smithwrinch/pcompproject/sonar.jpg

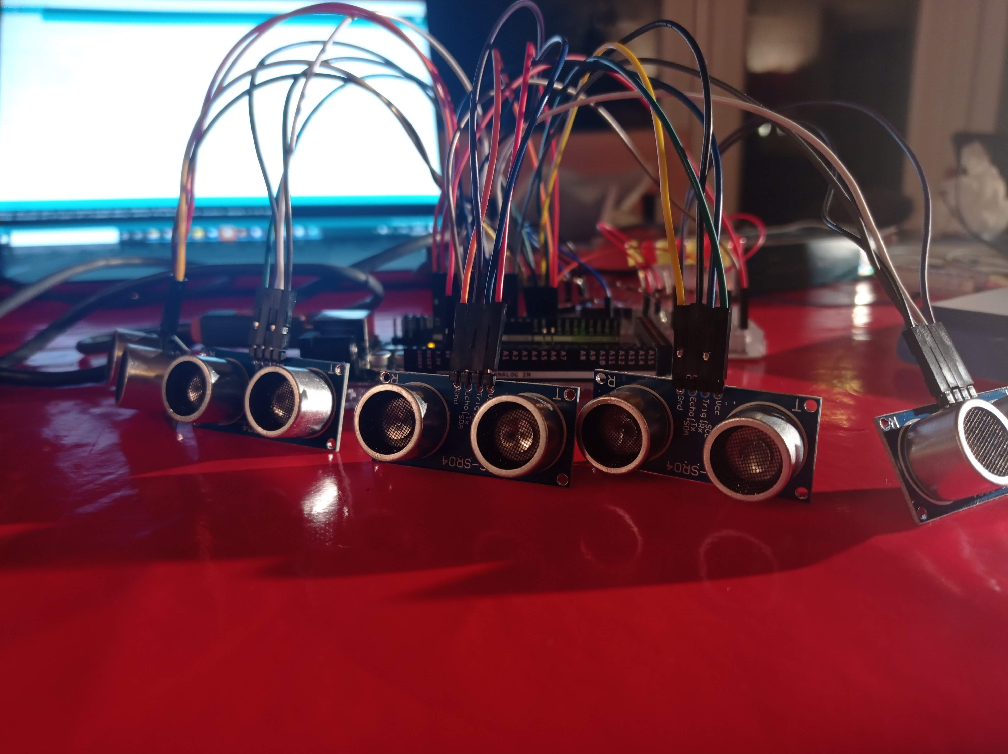
sonar.jpg
