smithwrinch/pcompproject/strip_wires.jpg

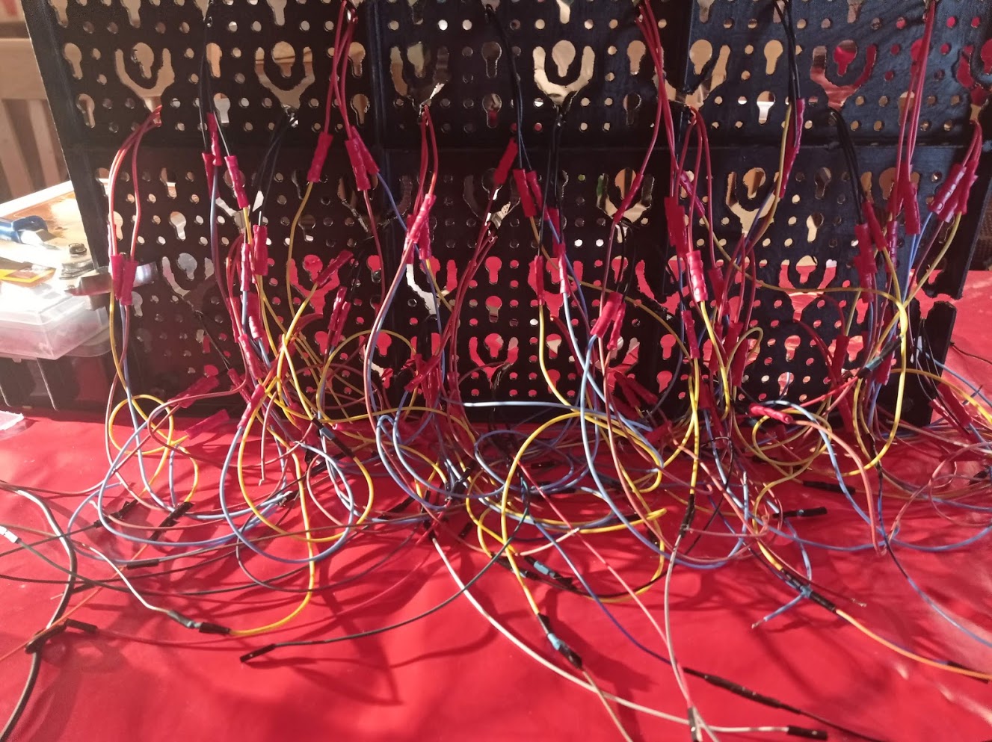
strip_wires.jpg
