smithwrinch/pcompproject/tiny_strip.jpg

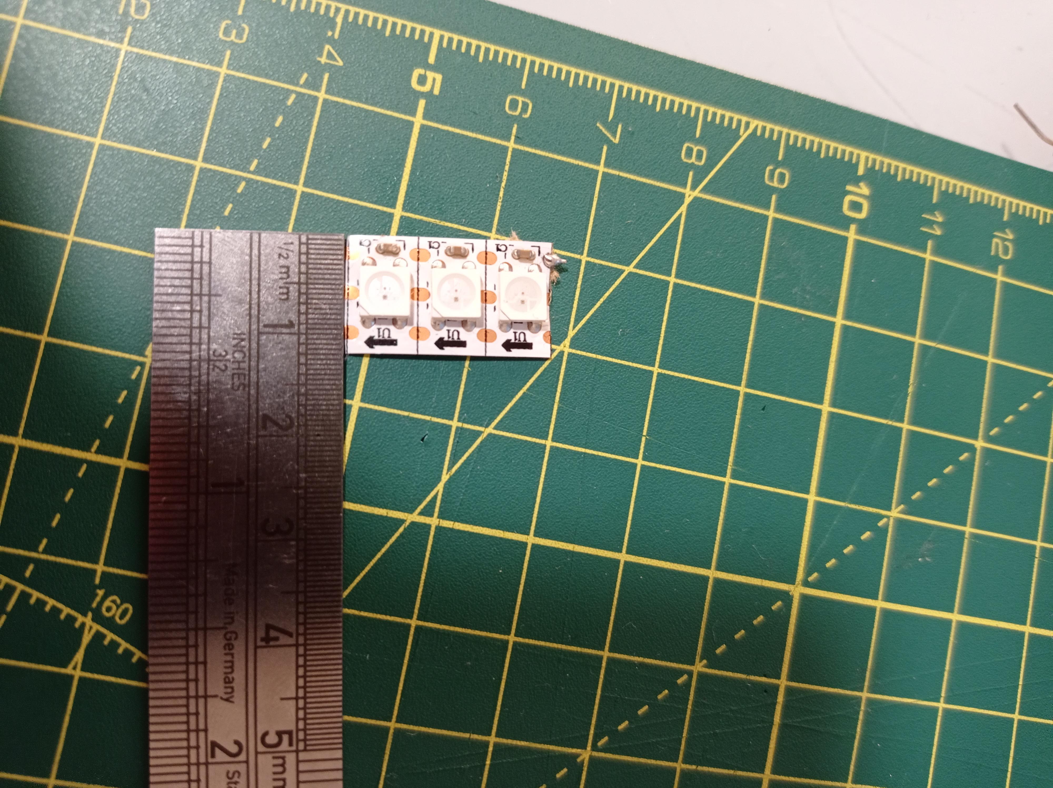
tiny_strip.jpg
