smithwrinch/pcompproject/test_strip.jpg

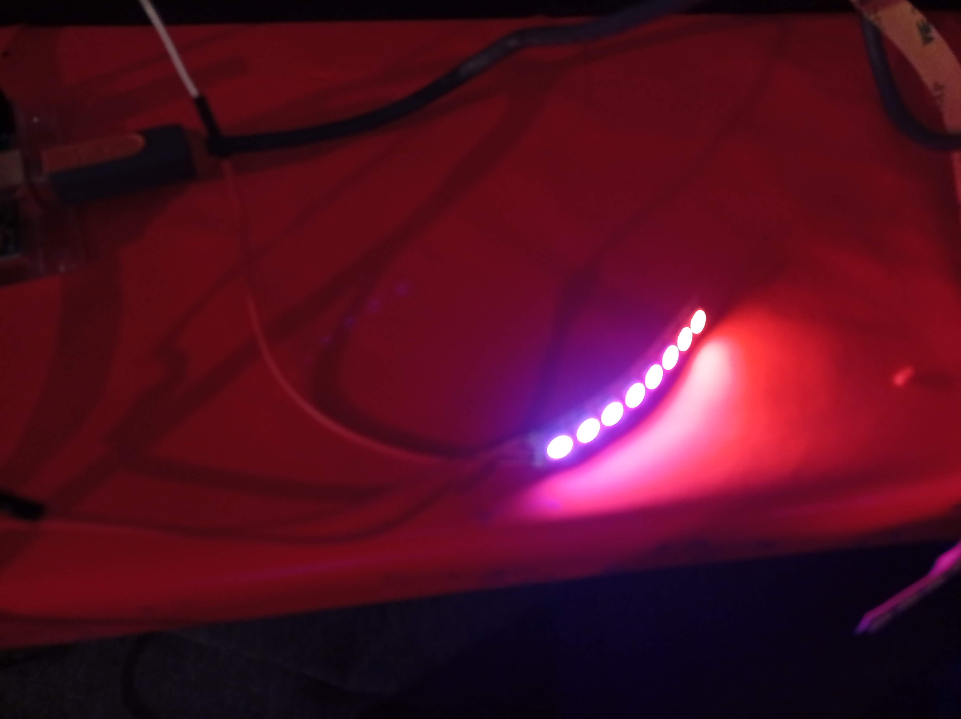
test_strip.jpg
